mavory/Smart-Rotating-Platform/README.md

# Smart-Rotating-Platform
SRP is a smart system controlled by ESP32. It can control a platform that is illuminated by a neopixel ring, all using buttons and the web!



## Why did I do this?

I wanted to create a project where I could put a thing on a platform and plug it in, then it would spin. So I thought about it and created this!

## Features

- Web interface
- It has a buzzer for notification
- Platform rotation with speed adjustment
- Neopixel ring for lighting

## Scripts

The script has approximately 230 lines, at the top you can add WiFi and password, then the system will be connected to the internet! Just upload it to the ESP32 and everything should work.

### Home page:


## How it works?

- If you turn on the system and if everything is written correctly, the ESP32 will connect to the internet and you can control everything via the web!
- On the OLED display you can see the speed of the motor and whether it is spinning. 
- You can also see the IP address to which the system is connected.
- You can control various things via the buttons and you can also map them to something else in the code yourself!

### Libraries:

```
WiFi.h
ESPAsyncWebServer.h
AccelStepper.h
Adafruit_SSD1306.h
Adafruit_NeoPixel.h
```

## 3D models

https://www.tinkercad.com/things/j0OOxEkqtwP-platform?sharecode=f9O0KSYpNDVq5MAwKAr93FbKLgL8qyi1mZk7fG3vbRg

Here is a view of the top and bottom of the case:

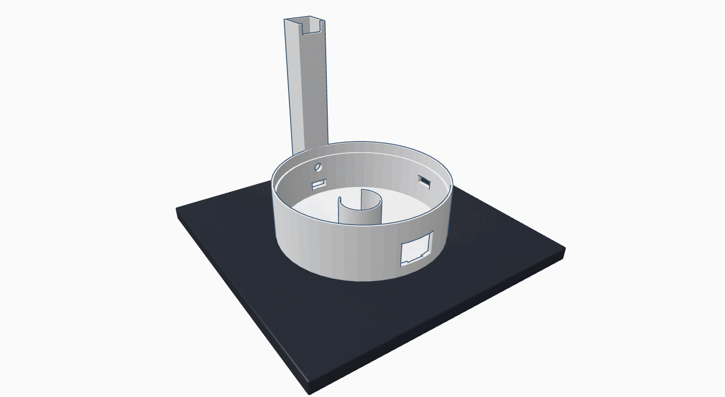
[picture p1: Photos/Snímek obrazovky 2026-01-25 113950.png]


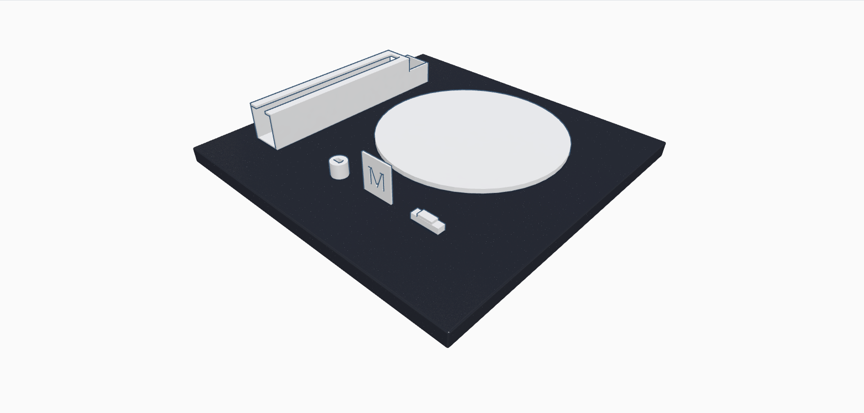
[picture p2: Photos/Snímek obrazovky 2026-01-25 113855.png]


## Wiring Diagram





## Bill of Materials (BOM)

| Item | Quantity | Link |
|---|---|---|
| ESP32 | 1 | [AliExpress](https://www.aliexpress.com/item/1005009694232832.html) |
| Breadboards | 2 | [AliExpress](https://www.aliexpress.com/item/1005007493250982.html) |
| Touch sensor | 1 | [AliExpress](https://www.aliexpress.com/item/1005008974368078.html) |
| Buzzer | 1 | [AliExpress](https://www.aliexpress.com/item/1005006260328559.html) |
| Jumpers | Much | [AliExpress](https://www.aliexpress.com/item/1005002611994443.html) |
| Button | 1 | [AliExpress](https://www.aliexpress.com/item/1005007197228321.html) |
| Neopixel ring | 1 | [AliExpress](https://www.aliexpress.com/item/1005008125328620.html) |
| OLED display | 1 | [AliExpress](https://www.aliexpress.com/item/32896971385.html) |
| Stepper motor | 1 | [AliExpress](https://www.aliexpress.com/item/1005007004416294.html) |

## There is the final video of how it works!

_Here is a youtube video where you can see how it works:_ [Link](https://youtu.be/nypfZz_uRD4)
