mavory/Smart-Rotating-Platform/Photos/20260120_210816.jpg

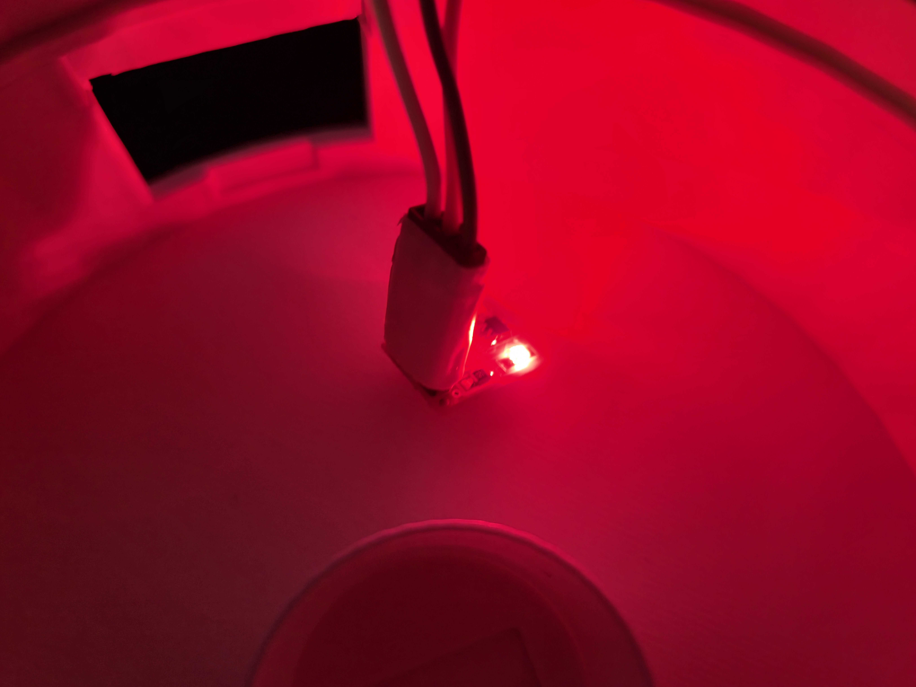
Photos/20260120_210816.jpg
