mavory/Smart-Rotating-Platform/Photos/20260121_150516.jpg

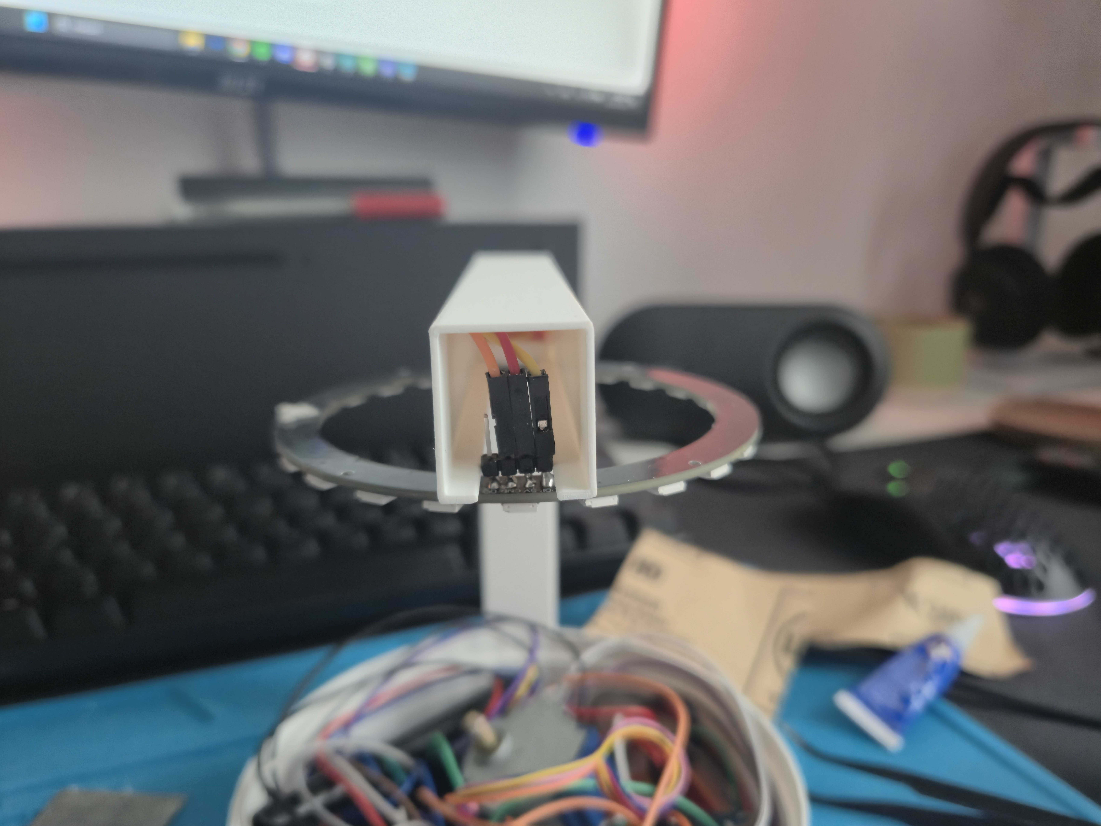
Photos/20260121_150516.jpg
