mavory/Smart-Rotating-Platform/BOM.csv

Item | Quantity | Link
ESP32 | 1 | https://www.aliexpress.com/item/1005009694232832.html?curPageLogUid=bPYYmnweQOZ8
Breadboards | 2 | https://www.aliexpress.com/item/1005007493250982.html?scm_id=1007.40050.354490.0&scm-url=1007.40050.354490.0
Touch senzor | 1 | https://www.aliexpress.com/item/1005008974368078.html?curPageLogUid=gx5Hev25NySc
Buzzer | 1 | https://www.aliexpress.com/item/1005006260328559.html?curPageLogUid=u9zf8d5xh8uM
Jumpers | Much | https://www.aliexpress.com/item/1005002611994443.html?curPageLogUid=fx2zB0EGcu5H
Button | 1 | https://www.aliexpress.com/item/1005007197228321.html?curPageLogUid=niWf4yREvIVl
Neopixel ring | 1 | https://www.aliexpress.com/item/1005008125328620.html
OLED display | 1 | https://www.aliexpress.com/item/32896971385.html
Stepper motor | 1 | https://www.aliexpress.com/item/1005007004416294.html?curPageLogUid=uO5nxFA42XTD
