mavory/Smart-Rotating-Platform/CAD/Main/Top part.step

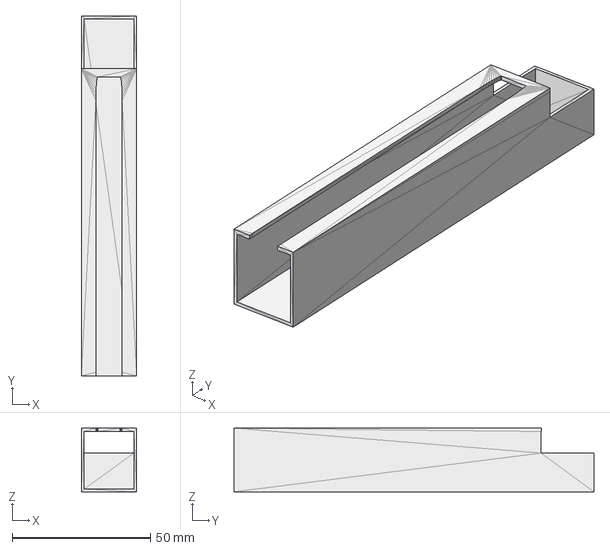
[picture p13: CAD file, 2026-01-25]
CAD/Main/Top part.step
20.0 x 130.0 x 23.0 mm
