mavory/Smart-Rotating-Platform/CAD/Other/Safety pin.step

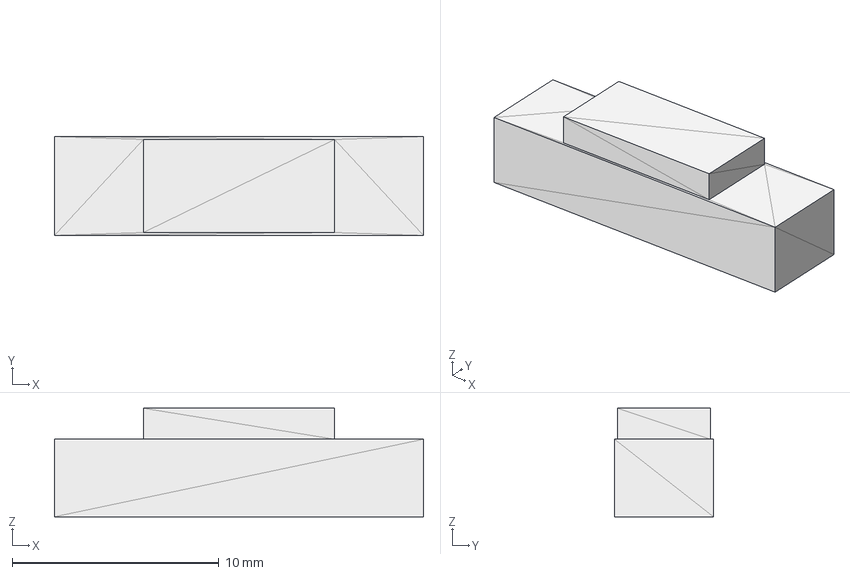
[picture p14: CAD file, 2026-01-25]
CAD/Other/Safety pin.step
17.9 x 4.78 x 5.25 mm
