mavory/Smart-Rotating-Platform/CAD/Main/Rotating platform.step

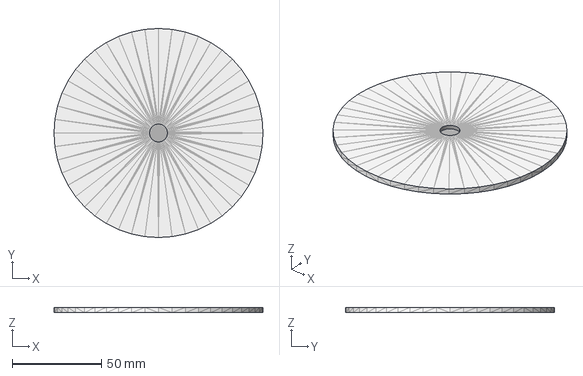
[picture p15: CAD file, 2026-01-25]
CAD/Main/Rotating platform.step
117.0 x 117.0 x 3.00 mm
