mavory/Smart-Rotating-Platform/CAD/Other/Stopper.step

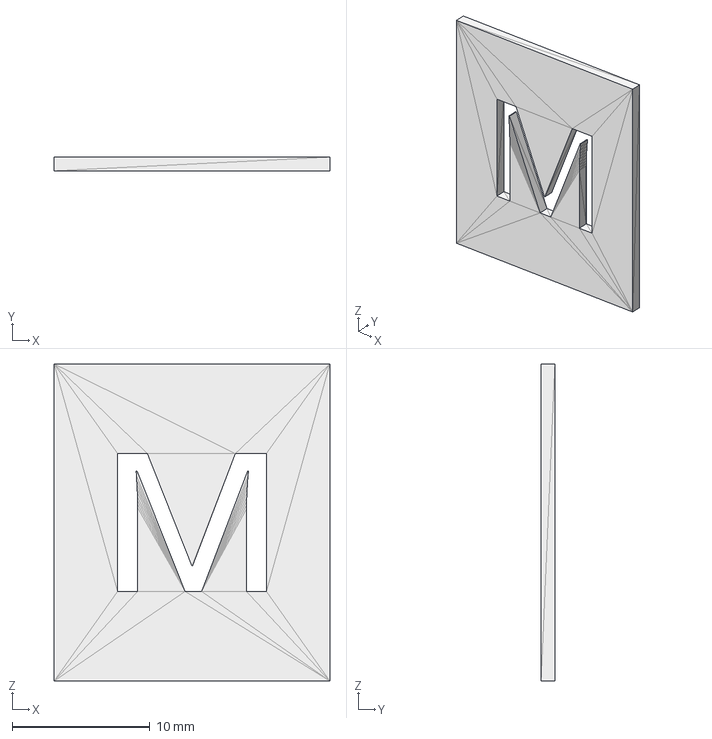
[picture p16: CAD file, 2026-01-25]
CAD/Other/Stopper.step
20.0 x 1.00 x 23.0 mm
