mavory/Smart-Rotating-Platform/CAD/Main/Case.step

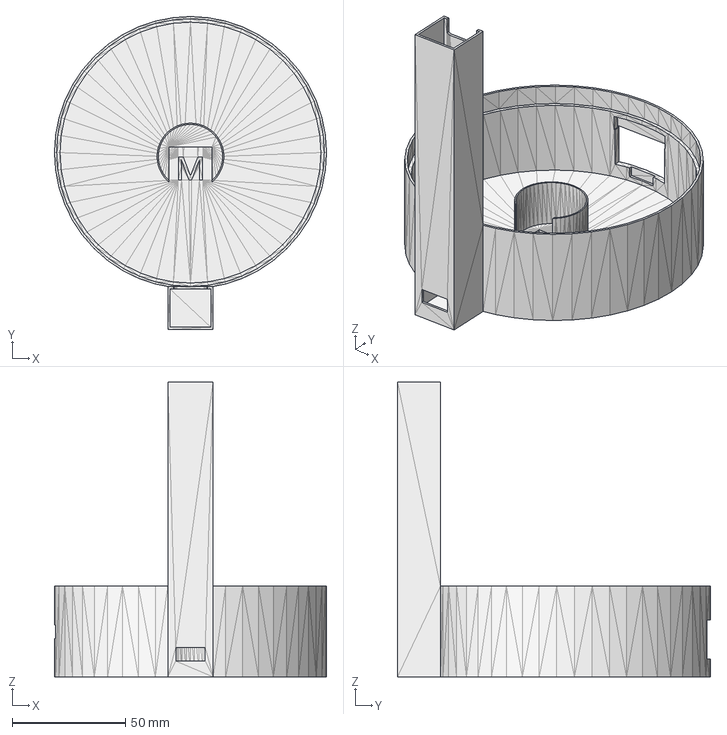
[picture p17: CAD file, 2026-01-25]
CAD/Main/Case.step
120.0 x 138.0 x 130.0 mm
