mavory/Smart-Rotating-Platform/CAD/Other/Holder.step

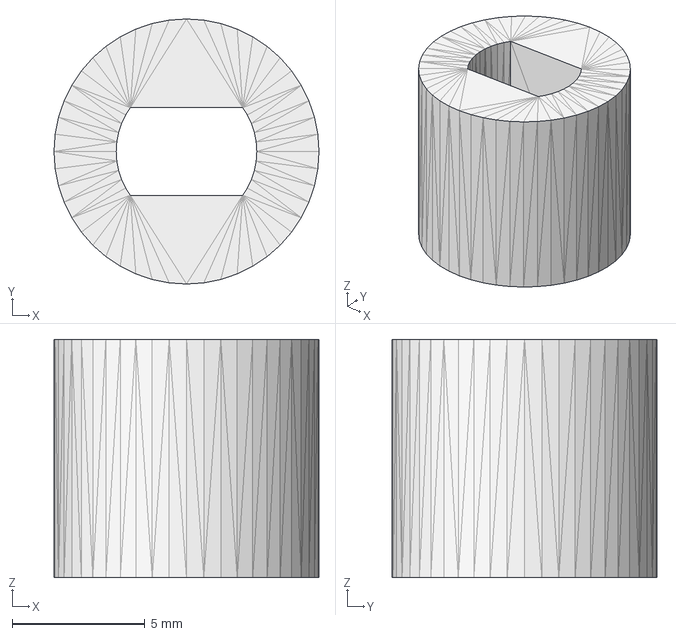
[picture p18: CAD file, 2026-01-25]
CAD/Other/Holder.step
10.0 x 10.0 x 9.00 mm
