mavory/Smart-Rotating-Platform/Circuit diagram/Wiring diagram/circuit_image (1).png

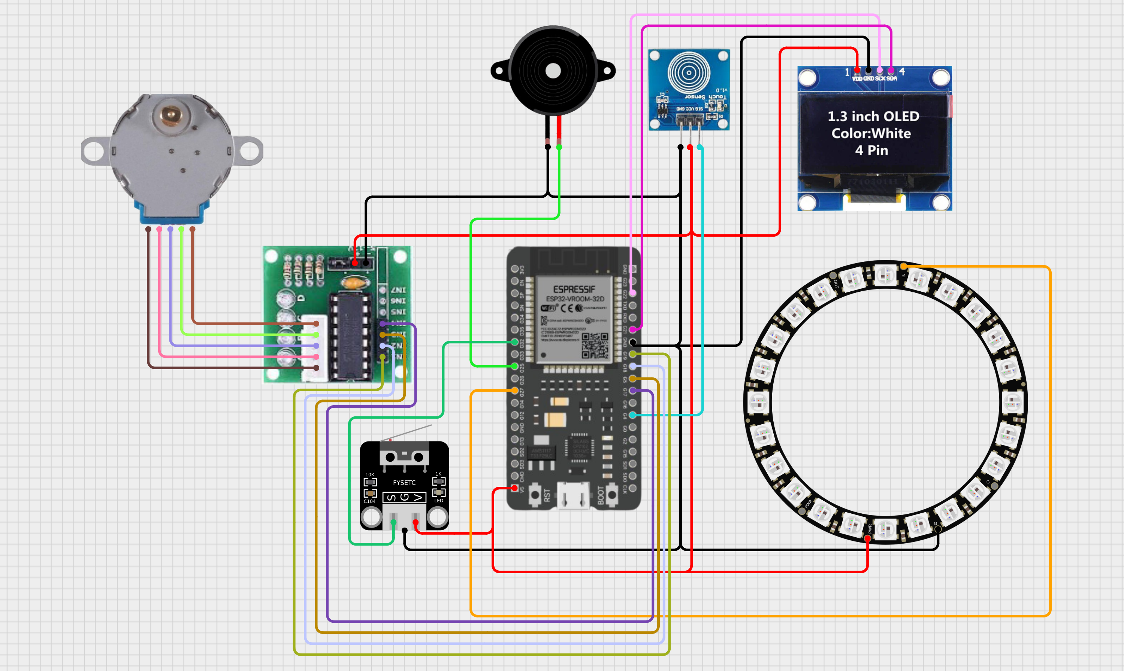
Circuit diagram/Wiring diagram/circuit_image (1).png
