mavory/Smart-Rotating-Platform/Circuit diagram/Platform.pdf

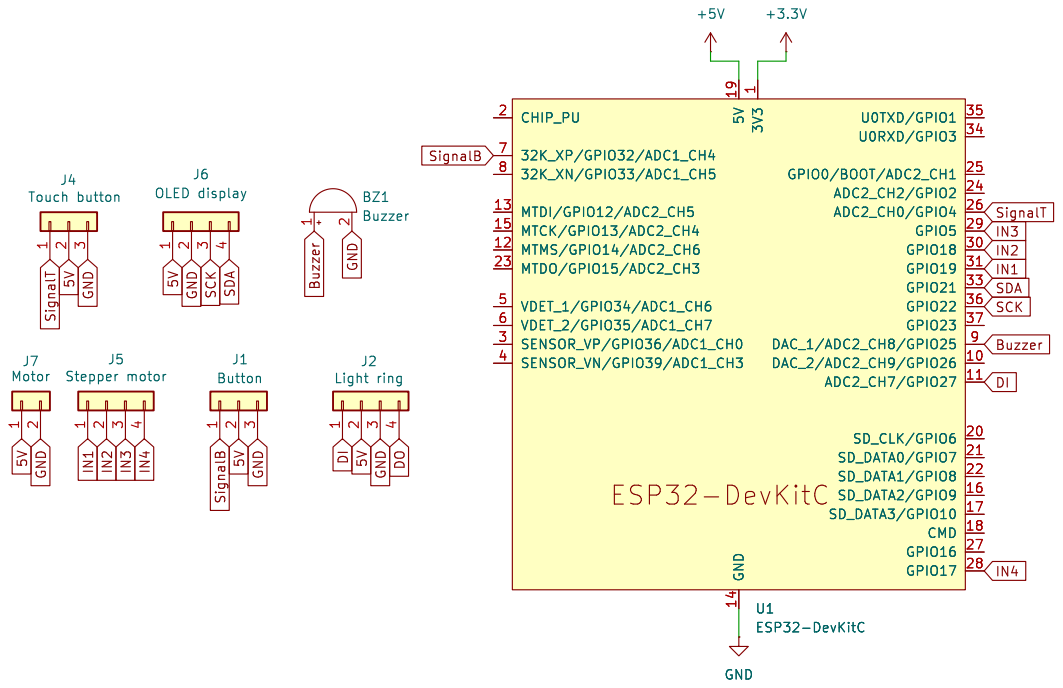
[picture p20: page 1]

2 BZ1 Buzzer +3.3V GND5V SignalT IN1 IN2 IN3 IN4 GND5VDI 5VDO SignalB GND GND

File: ESP32.kicad_sch Sheet: /
Id: 1/1 Title: Smart Rotating Platform
