mavory/Smart-Rotating-Platform/Circuit diagram/Platform.kicad_sch

## KiCad design Circuit diagram/Platform.kicad_sch (2026-01-25)

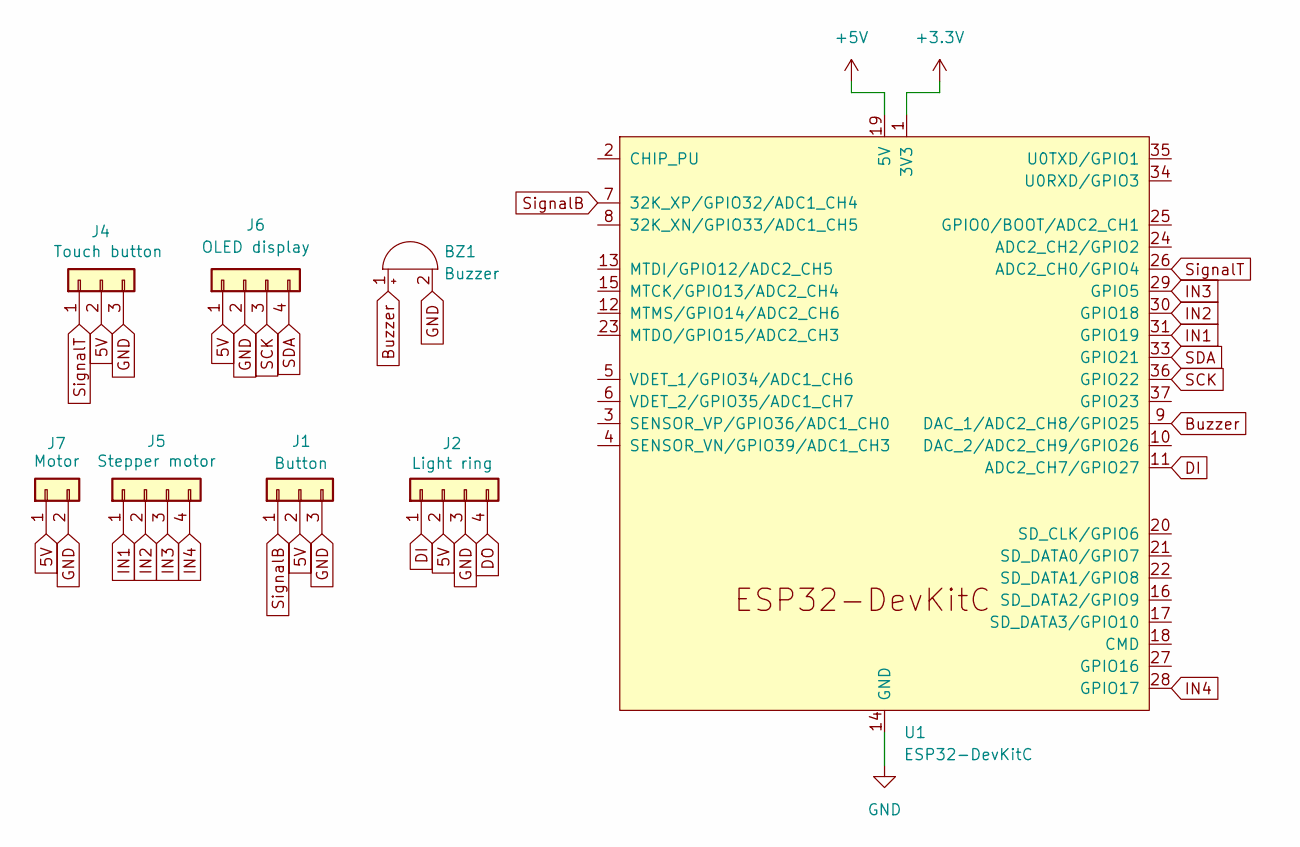
[picture p21: schematic Platform.kicad_sch]

Parts:
BZ1: Buzzer
J1: Button
J2: Light ring
J4: Touch button
J5: Stepper motor
J6: OLED display
J7: Motor
U1: ESP32-DevKitC

Connections:
5V: J1.2, J2.2, J4.2, J6.1, J7.1
+3.3V: U1.1 (3V3)
+5V: U1.19 (5V)
Buzzer: BZ1.1 (+), U1.9 (DAC_1/ADC2_CH8/GPIO25)
DI: J2.1, U1.11 (ADC2_CH7/GPIO27)
DO: J2.4
GND: BZ1.2 (-), J1.3, J2.3, J4.3, J6.2, J7.2, U1.14 (GND), U1.32 (GND), U1.38 (GND)
IN1: J5.1, U1.31 (GPIO19)
IN2: J5.2, U1.30 (GPIO18)
IN3: J5.3, U1.29 (GPIO5)
IN4: J5.4, U1.28 (GPIO17)
SCK: J6.3, U1.36 (GPIO22)
SDA: J6.4, U1.33 (GPIO21)
SignalB: J1.1, U1.7 (32K_XP/GPIO32/ADC1_CH4)
SignalT: J4.1, U1.26 (ADC2_CH0/GPIO4)
