mavory/Smart-Rotating-Platform/(commit log)

2026-01-25 .STEP files
    [Case.step, Rotating platform.step, Top part.step]
2026-01-25 Circuit diagram
    [Platform.kicad_sch]
2026-01-25 README.md
    Added detailed project description, features, and wiring diagram.
2026-02-01 Circuit and Wiring Diagram
2026-02-01 README.md
    Added a new wiring diagram image to the README.
2026-02-01 Journal.md
    Updated time spent on various project tasks and improved descriptions of project progress. Added circuit diagram and bill of materials.
