mavory/Smart-Rotating-Platform/Photos/20260120_204931.jpg

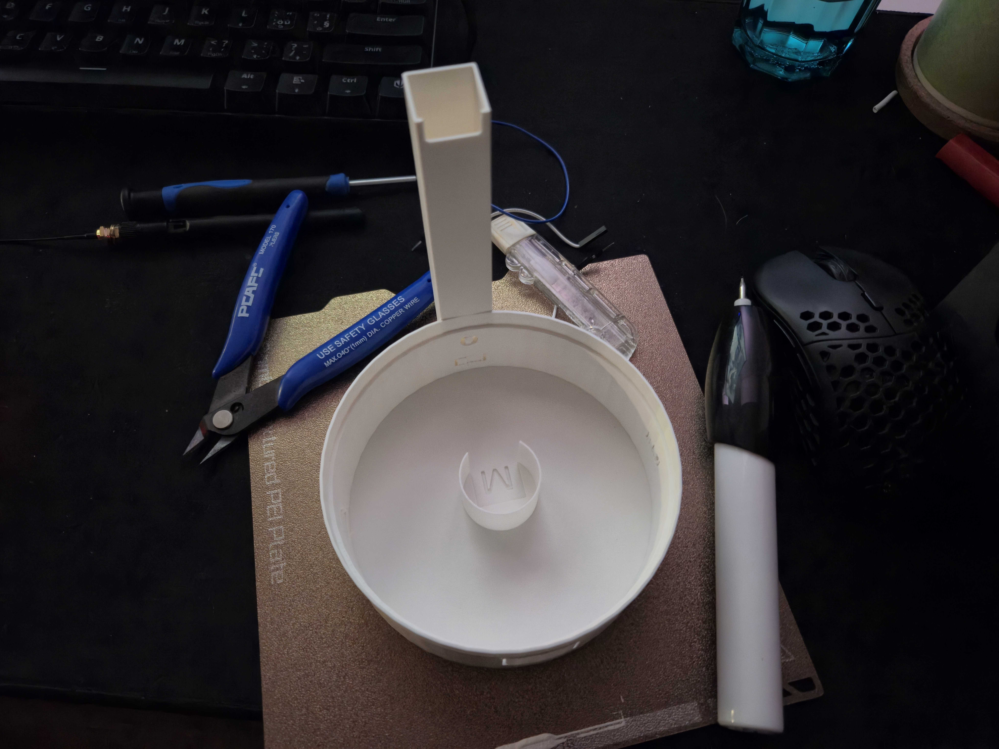
Photos/20260120_204931.jpg
