mavory/Smart-Rotating-Platform/Photos/20260120_205810.jpg

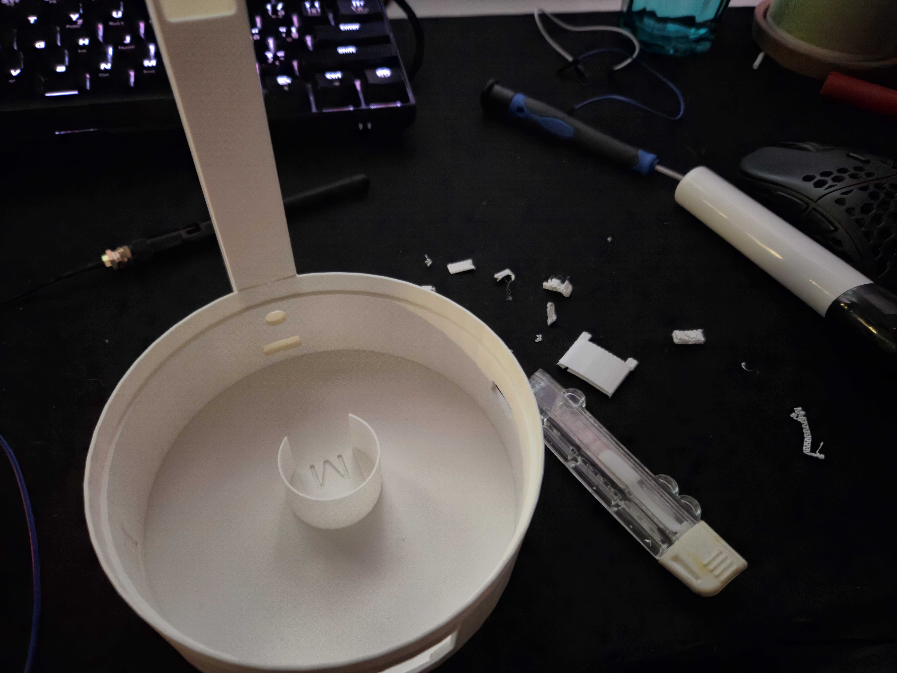
Photos/20260120_205810.jpg
