mavory/Smart-Rotating-Platform/Photos/20260121_121501.jpg

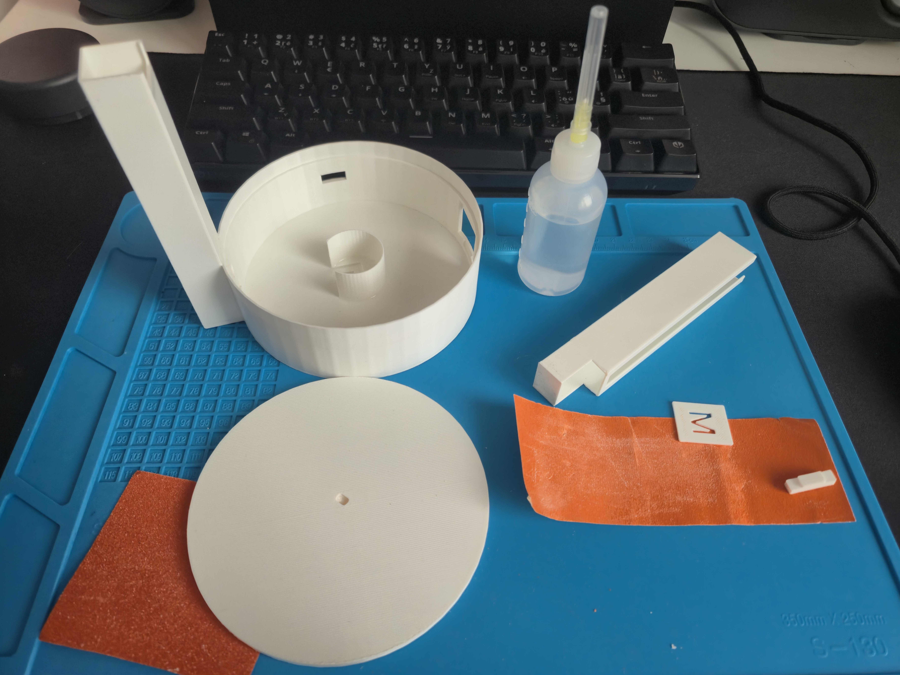
Photos/20260121_121501.jpg
