mavory/Smart-Rotating-Platform/Photos/20260121_150007.jpg

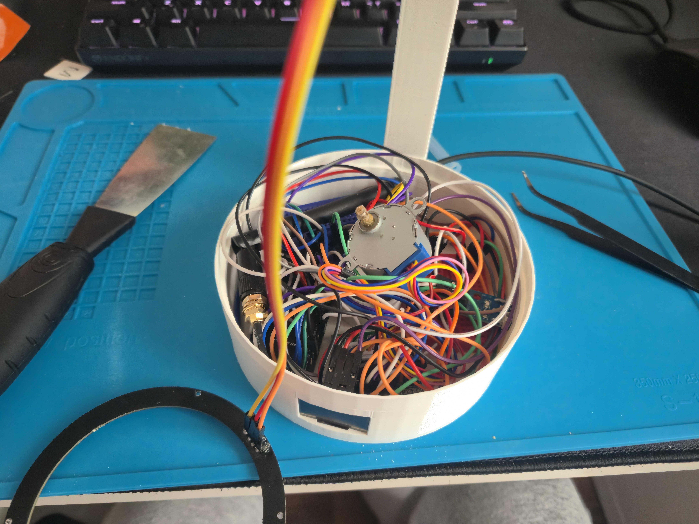
Photos/20260121_150007.jpg
