mavory/Smart-Rotating-Platform/Photos/20260121_151427.jpg

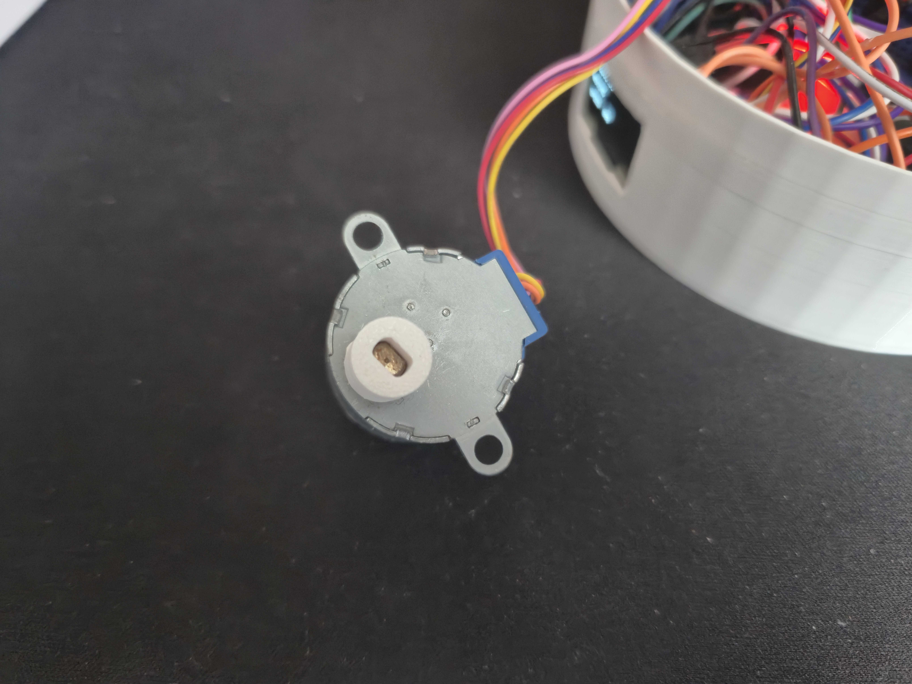
Photos/20260121_151427.jpg
