mavory/Smart-Rotating-Platform/Photos/20260121_175356.jpg

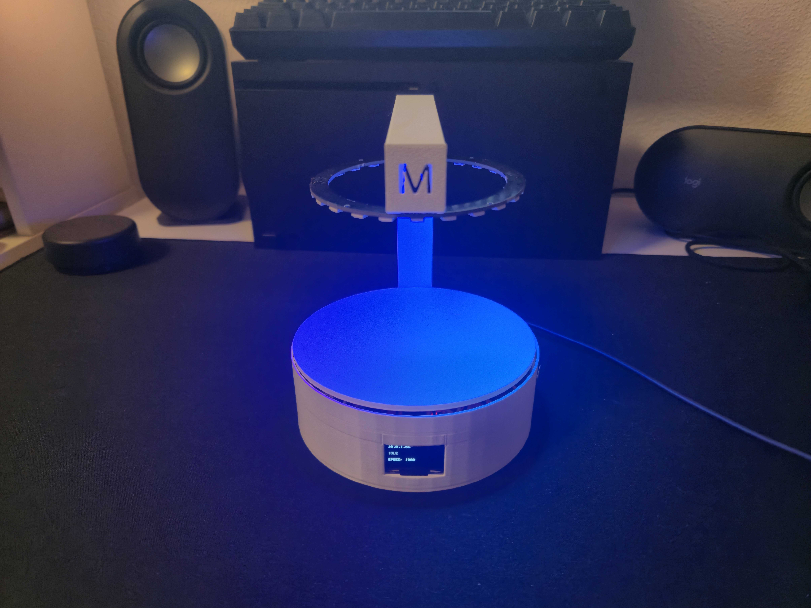
Photos/20260121_175356.jpg
