mavory/Smart-Rotating-Platform/Photos/1000024078.jpg

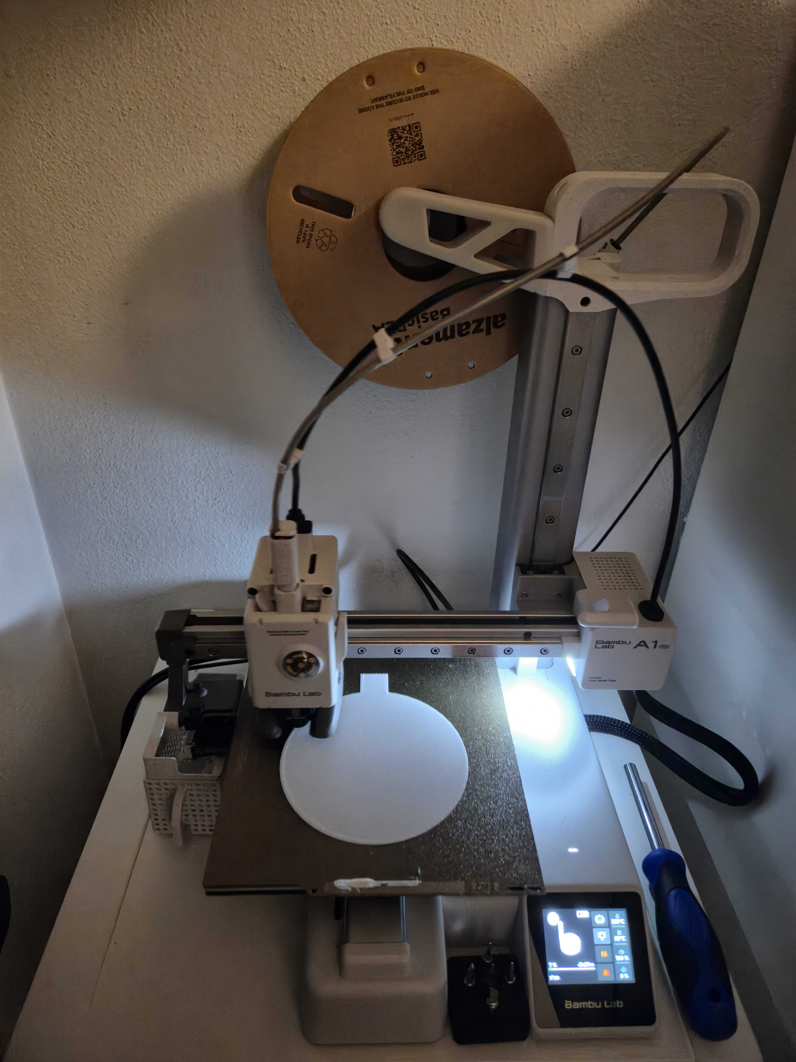
Photos/1000024078.jpg
