mavory/Smart-Rotating-Platform/Photos/1000024156.jpg

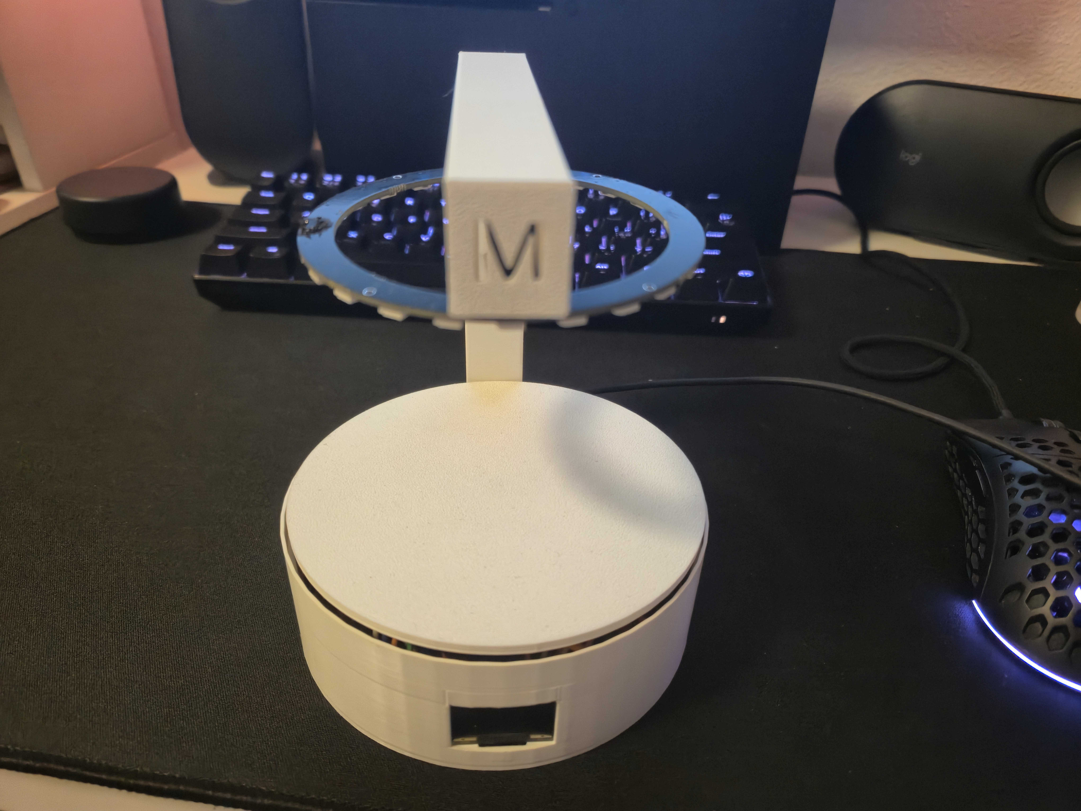
Photos/1000024156.jpg
